PU2REO/PU2REO_DVFO/Documents/Arduino-Nano-pinout-1.jpg

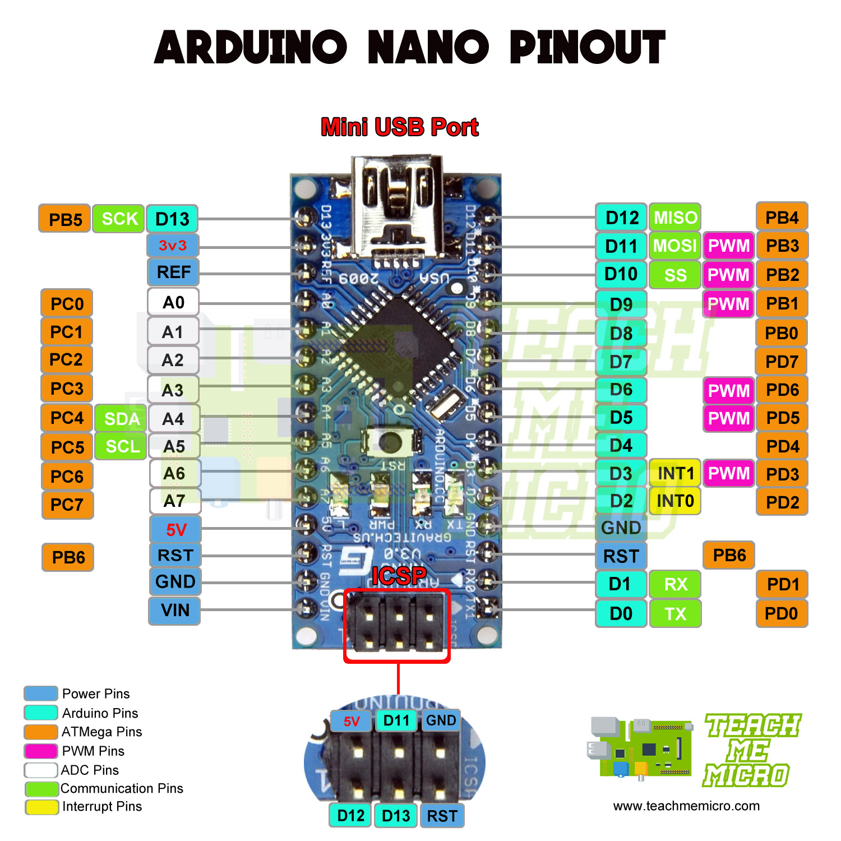
Documents/Arduino-Nano-pinout-1.jpg
