PU2REO/PU2REO_DVFO/Images/Image02.jpeg

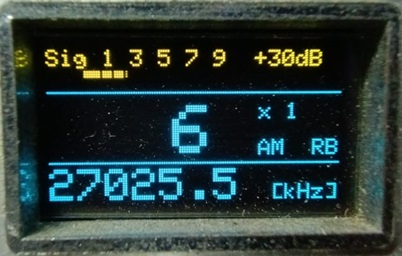
Images/Image02.jpeg
