PU2REO/PU2REO_DVFO/Images/Image03.jpeg

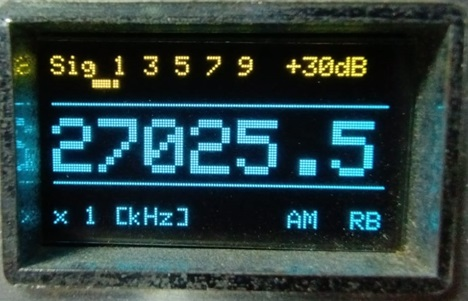
Images/Image03.jpeg
