PU2REO/PU2REO_DVFO/(threads)

Thread 1 (2024-08-21):

Are the gerber files available

kb2sdr, 2024-08-21:
Hello,

I noticed you have pictures of the circuit boards for the Arduino and amplifier. Would it be possible to add the gerber files to the repo?

73
Jason
KB2SDR

PU2REO, 2024-08-22:
Hello and thanks for your message!!

For sure it is!

I'm away from home these days and without my tech gear.

As soon as I get home, will do that!
(Please, drop a message again if you haven't heard of me in a week!! 😜)

73's, REO.

PU2REO, 2024-08-25:
It's done.

kb2sdr, 2024-08-25:
Thank you very much!

73
KB2SDR

Closed 2024-08-25.
