PU2REO/PU2REO_DVFO/Schematics/DigitalVFO.PDF

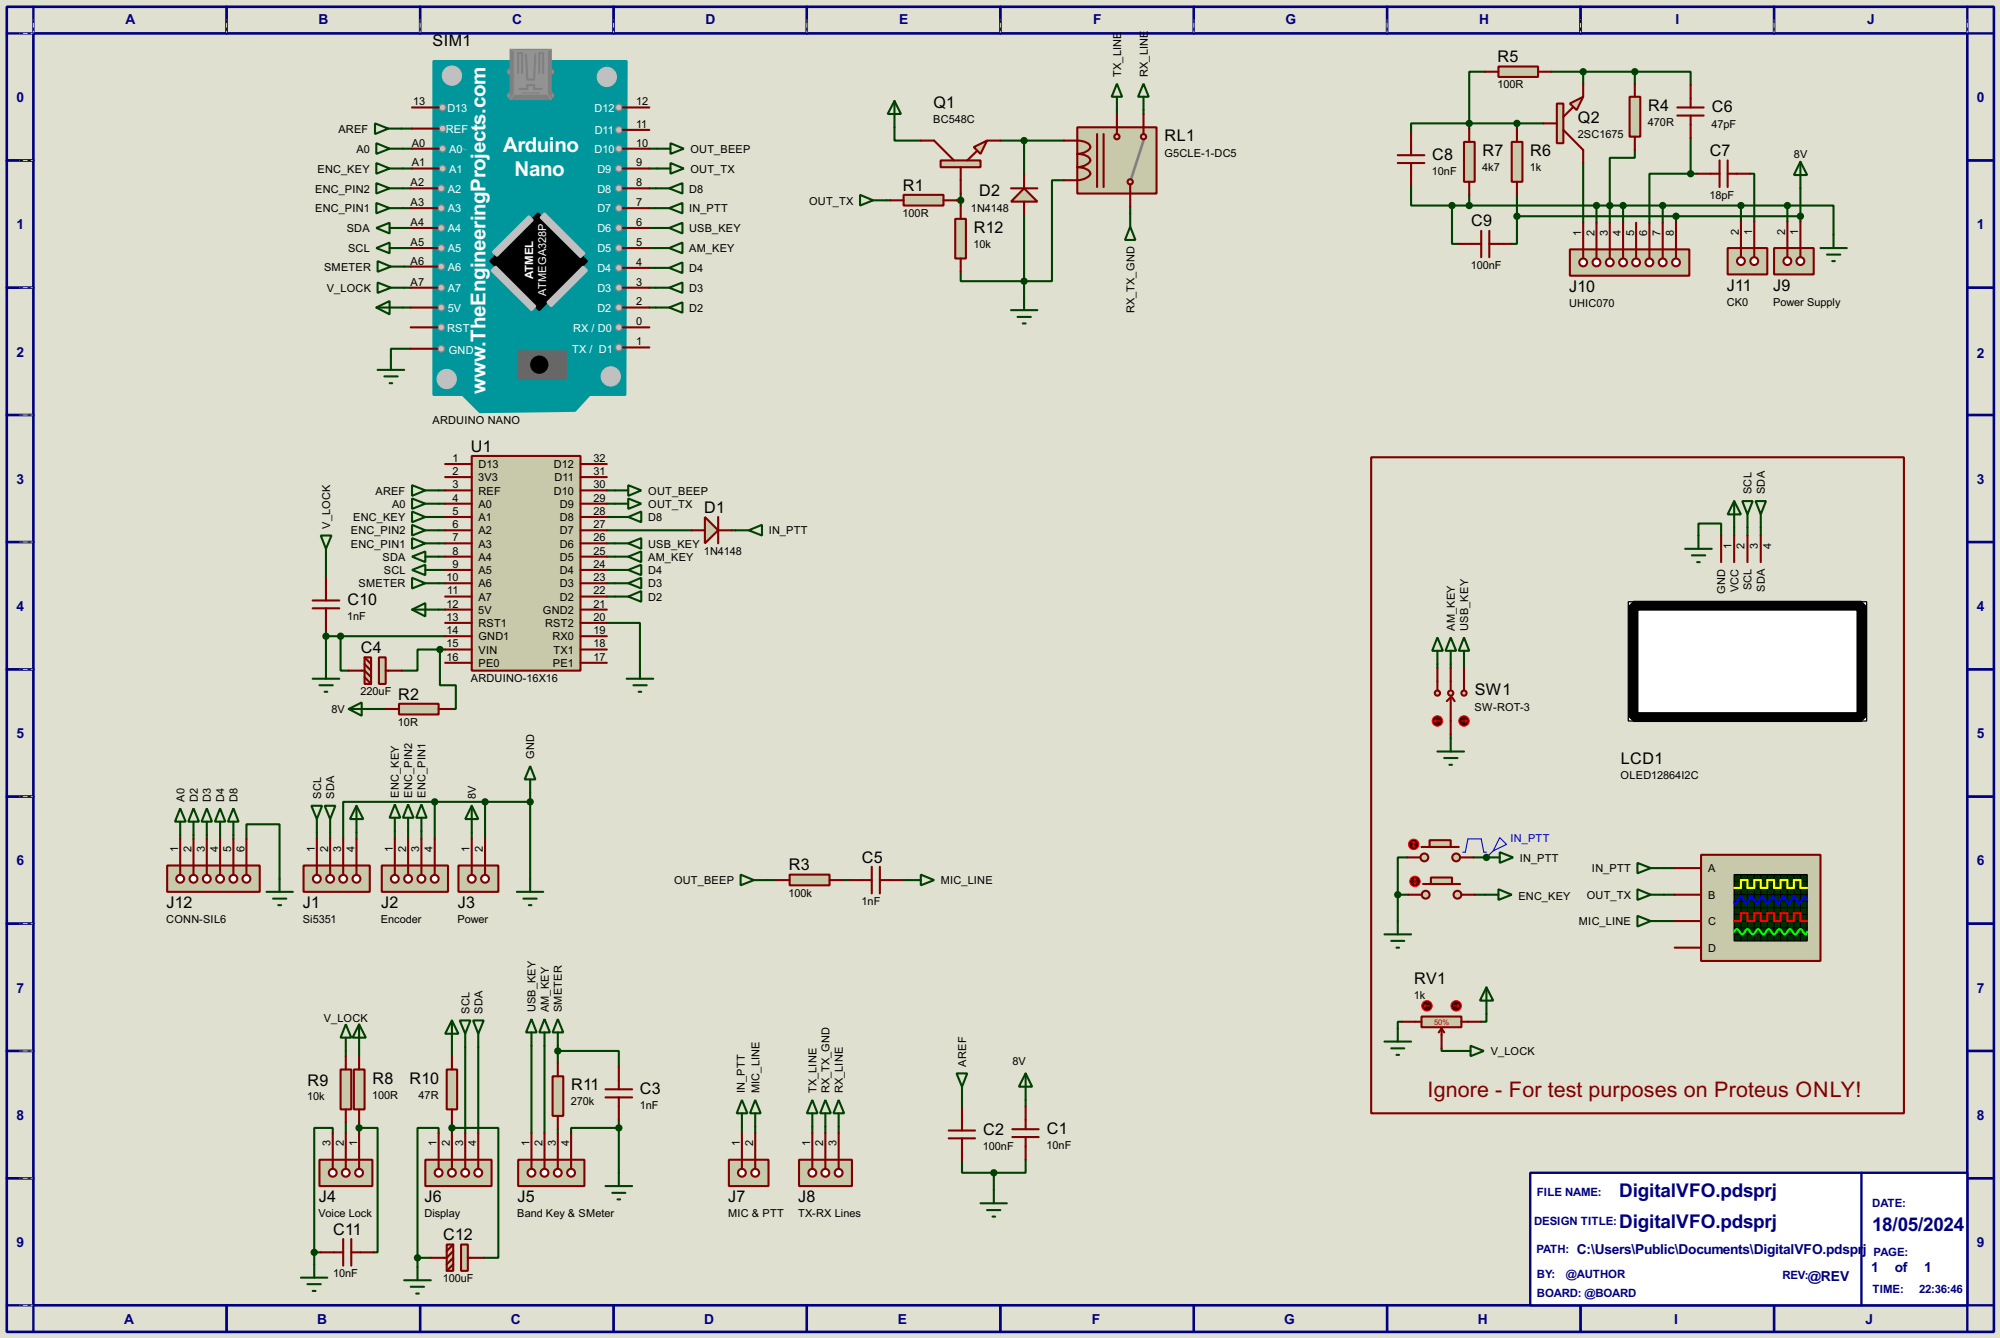
[picture p34: page 1]
