PU2REO/PU2REO_DVFO/Schematics/PCB_EPT014811Z.pdf

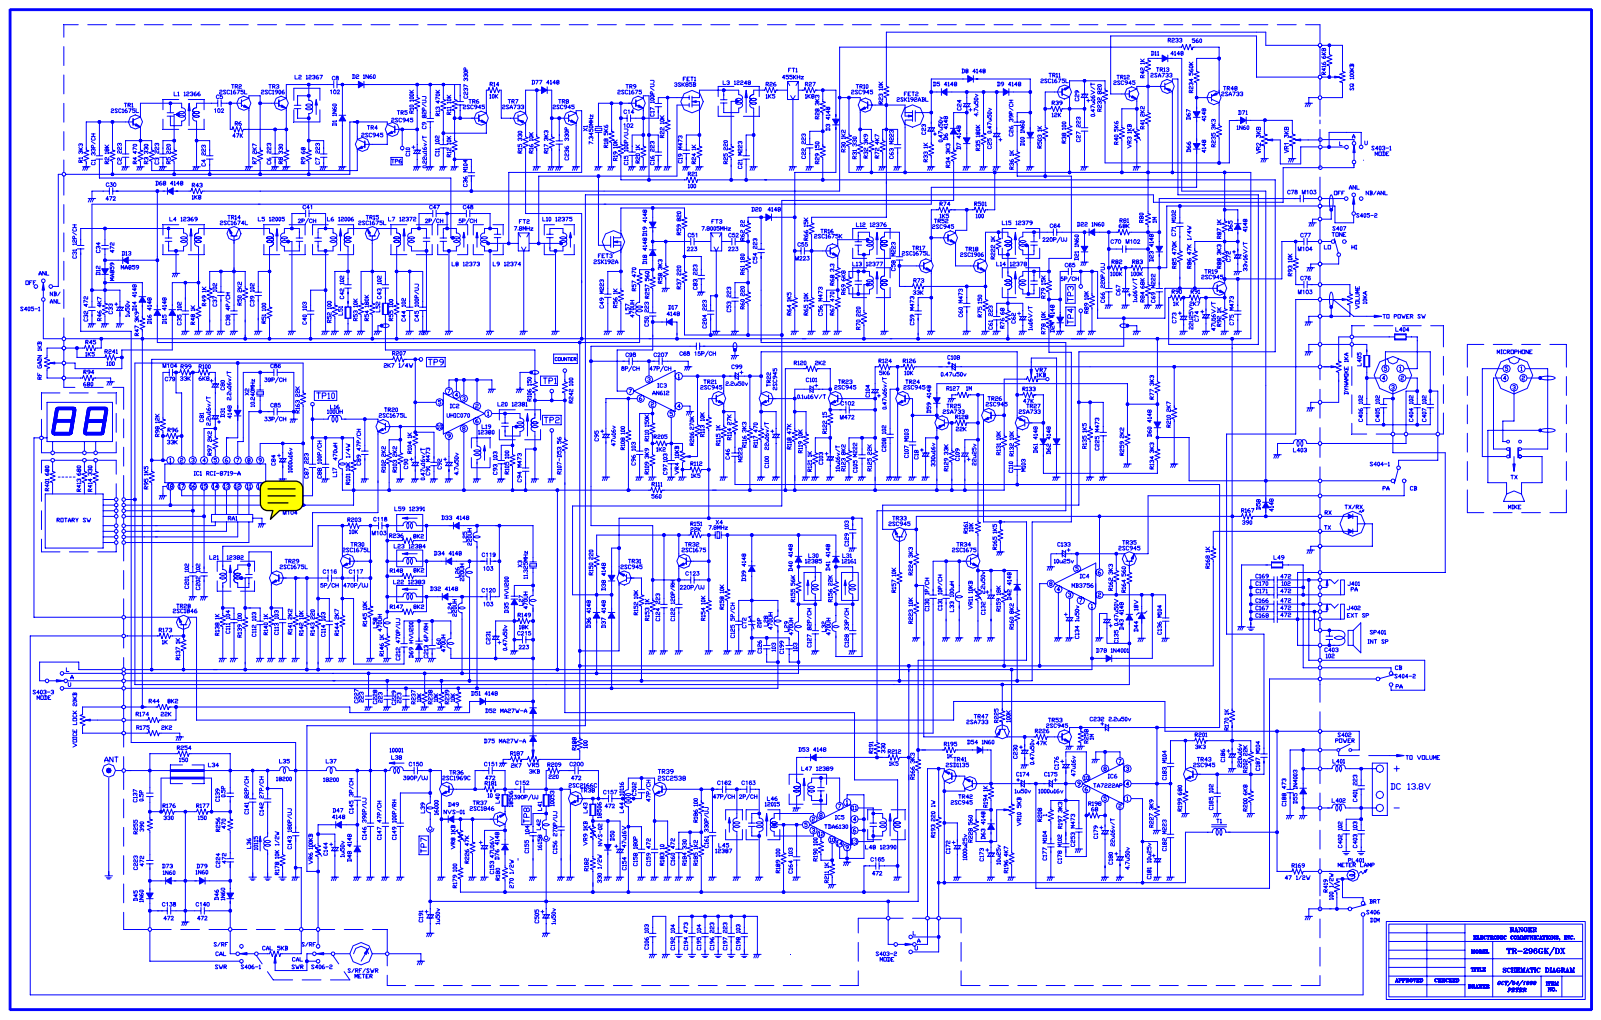
[picture p35: page 1]
