PU2REO/PU2REO_DVFO/(commit log)

2024-01-01 Rename Arduino-Nano-pinout-1.jpg to Arduino-Nano-pinout-1.jpg
    Renaming
2024-05-19 1.0.1 – New pictures into the manual, minor correction to the schematics.
2024-05-19 1.1 – New pictures into the manual, minor correction to the schematics; Improvement on EEPROM saving routine
    [PU2REO_DVFO.ino]
2025-10-04 Update README.md
    Added you tube movies to README.md.
